Sleepdealr/RPAD/README.md

This work is licensed under a **Creative Commons Attribution-NonCommercial-ShareAlike 4.0 International License**.

# RPAD
A macropad designed using the RP2040

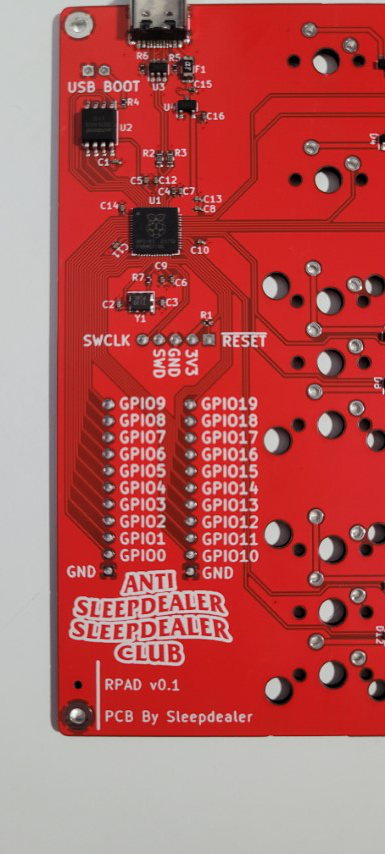
[picture p1: img/RPAD.jpg]
PDF of schematic
