Sleepdealr/RPAD/Firmware/rpad/readme.md

# RPAD

RPAD

*A short description of the keyboard/project*

* Keyboard Maintainer: [Sleepdealer](https://github.com/Sleepdealr)
* Hardware Supported: RPAD PCB
* Hardware Availability: *Links to where you can find this hardware*

Make example for this keyboard (after setting up your build environment):

    make sleepdealer/rpad:default

Flashing example for this keyboard by `picotool`:

    make sleepdealer/rpad:default:flash

Convert firmware into uf2 format:

    make sleepdealer/rpad:default:uf2

To replace Pro Micro to Pico Micro, use `CTPIM=yes` (`CONVERT_TO_PICO_MICRO=yes`):

    make <your_keyboard>:<your_keyamp>:<output option> CTPIM=yes

See the [build environment setup](https://docs.qmk.fm/#/getting_started_build_tools) and the [make instructions](https://docs.qmk.fm/#/getting_started_make_guide) for more information. Brand new to QMK? Start with our [Complete Newbs Guide](https://docs.qmk.fm/#/newbs).

## Bootloader

Enter the bootloader in 3 ways:

* **Bootmagic reset**: Hold down the key at (0,0) in the matrix (usually the top left key or Escape) and plug in the keyboard
* **Physical reset button**: Briefly press the button on the back of the PCB - some may have pads you must short instead
* **Keycode in layout**: Press the key mapped to `RESET` if it is available
