Sleepdealr/RPAD/PCB/RPAD.kicad_pcb

## KiCad design PCB/RPAD.kicad_pcb (2021-12-07)

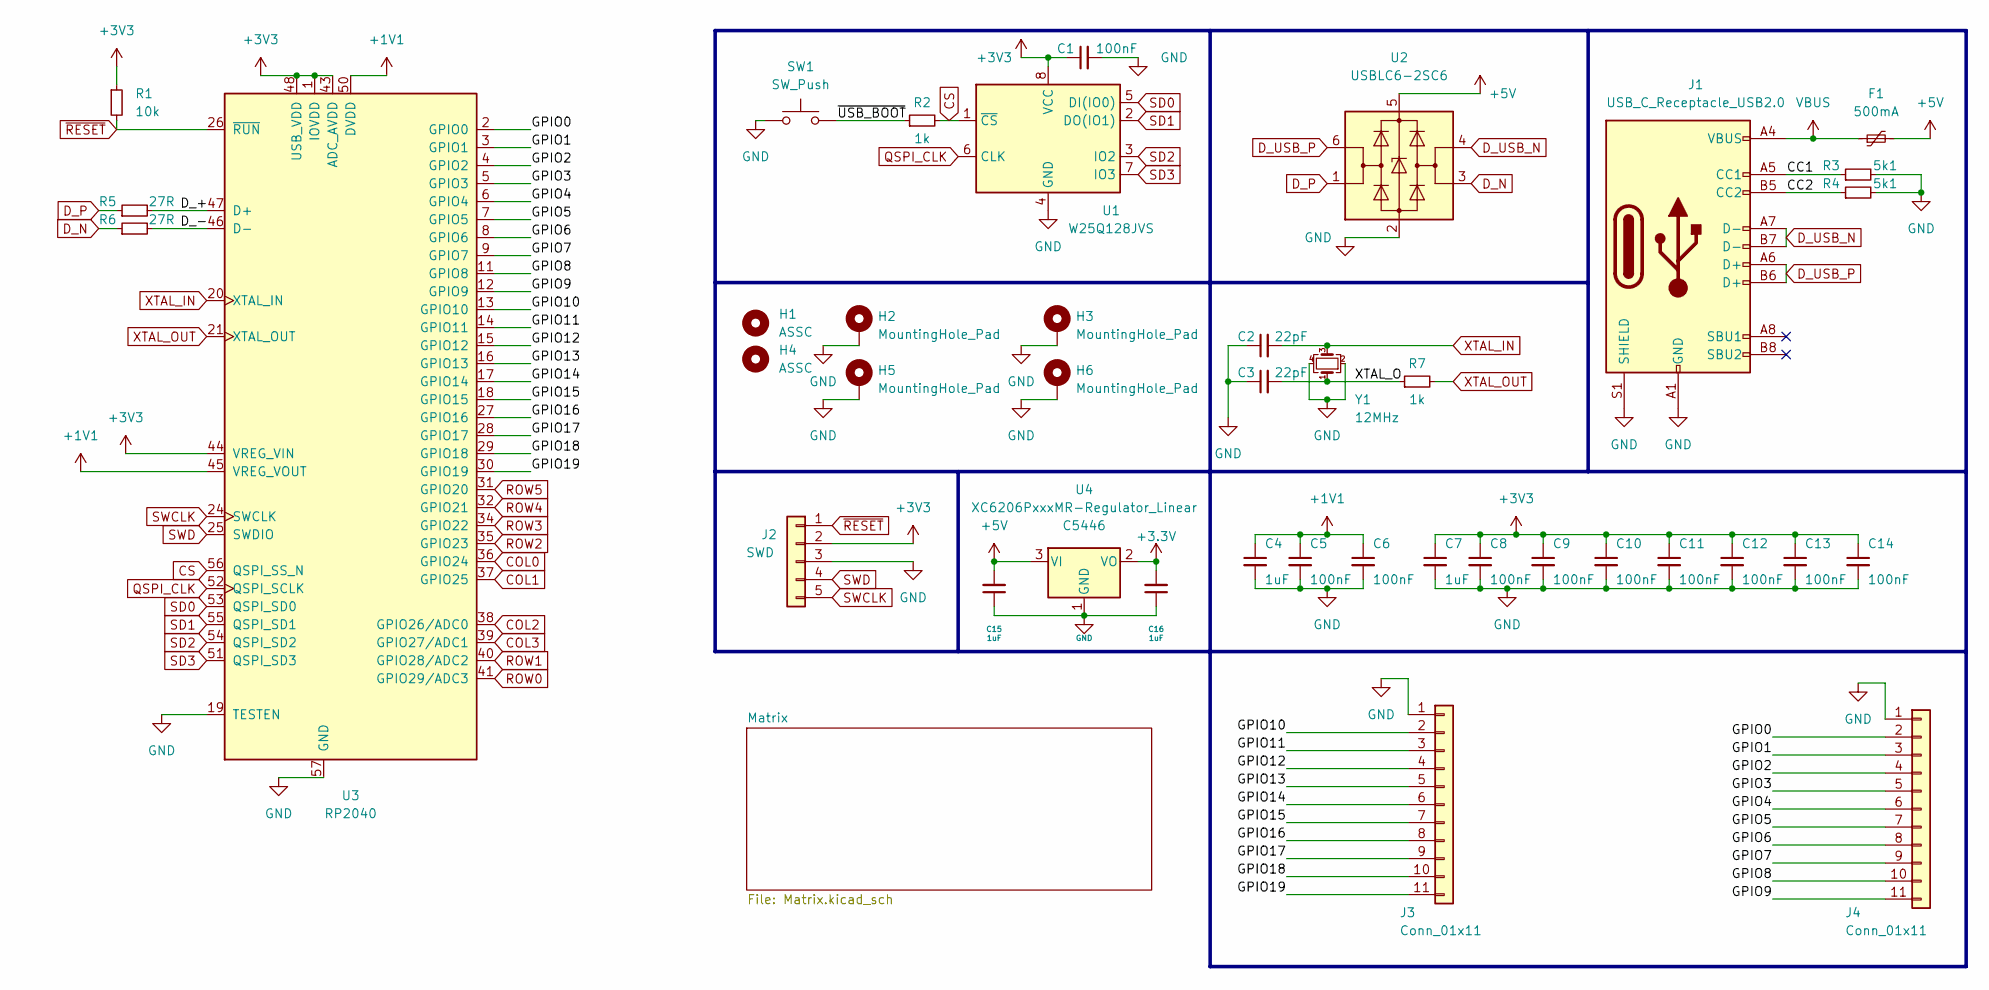
[picture p4: schematic RPAD.kicad_sch]

Parts:
C1, C5, C6, C8, C9, C10, C11, C12, C13, C14: 100nF; C_0402_1005Metric; LCSC C1525
C2, C3: 22pF; C_0402_1005Metric; LCSC C1555
C4, C7, C15, C16: 1uF; C_0402_1005Metric; LCSC C52923
F1: 500mA; Fuse_1206_3216Metric; LCSC C70076
H1, H4: ASSC; assc
H2, H3, H5, H6: MountingHole_Pad; MountingHole_2.2mm_M2_Pad
J1: USB_C_Receptacle_USB2.0; USB_C_Receptacle_HRO_TYPE-C-31-M-12; LCSC C165948
J2: SWD; PinSocket_1x05_P2.54mm_Vertical
J3, J4: Conn_01x11; PinSocket_1x11_P2.54mm_Vertical
R1: 10k; R_0402_1005Metric; LCSC C25744
R2, R7: 1k; R_0402_1005Metric; LCSC C11702
R3, R4: 5k1; R_0402_1005Metric; LCSC C25905
R5, R6: 27R; R_0603_1608Metric; LCSC C25190
SW1: SW_Push; PinSocket_1x02_P2.54mm_Vertical
U1: W25Q128JVS; SOIC-8_5.23x5.23mm_P1.27mm; LCSC C131025
U2: USBLC6-2SC6; SOT-23-6; LCSC C2827654
U3: RP2040; RP2040-QFN-56; LCSC C2040
U4: XC6206PxxxMR-Regulator_Linear; SOT-23; LCSC C5446
Y1: 12MHz; Crystal_SMD_3225-4Pin_3.2x2.5mm; LCSC C97242

Connections:
+1V1: C4.1, C5.1, C6.1, U3.23 (DVDD), U3.45 (VREG_VOUT), U3.50 (DVDD)
+5V: C15.2, F1.2, U2.5 (VBUS), U4.3 (VI)
/CC1: J1.A5 (CC1), R3.1
/CC2: J1.B5 (CC2), R4.1
/D_+: R5.2, U3.47 (D+)
/D_-: R6.2, U3.46 (D-)
/GPIO0: J4.2, U3.2 (GPIO0)
/GPIO1: J4.3, U3.3 (GPIO1)
/GPIO2: J4.4, U3.4 (GPIO2)
/GPIO3: J4.5, U3.5 (GPIO3)
/GPIO4: J4.6, U3.6 (GPIO4)
/GPIO5: J4.7, U3.7 (GPIO5)
/GPIO6: J4.8, U3.8 (GPIO6)
/GPIO7: J4.9, U3.9 (GPIO7)
/GPIO8: J4.10, U3.11 (GPIO8)
/GPIO9: J4.11, U3.12 (GPIO9)
/GPIO10: J3.2, U3.13 (GPIO10)
/GPIO11: J3.3, U3.14 (GPIO11)
/GPIO12: J3.4, U3.15 (GPIO12)
/GPIO13: J3.5, U3.16 (GPIO13)
/GPIO14: J3.6, U3.17 (GPIO14)
/GPIO15: J3.7, U3.18 (GPIO15)
/GPIO16: J3.8, U3.27 (GPIO16)
/GPIO17: J3.9, U3.28 (GPIO17)
/GPIO18: J3.10, U3.29 (GPIO18)
/GPIO19: J3.11, U3.30 (GPIO19)
/XTAL_O: C3.2, R7.1, Y1.1
/~USB_BOOT: R2.1, SW1.2
COL0: U3.36 (GPIO24); also elsewhere on the board
COL1: U3.37 (GPIO25); also elsewhere on the board
COL2: U3.38 (GPIO26/ADC0); also elsewhere on the board
COL3: U3.39 (GPIO27/ADC1); also elsewhere on the board
CS: R2.2, U1.1 (~CS), U3.56 (QSPI_SS_N)
D_N: R6.1, U2.3 (I/O2)
D_P: R5.1, U2.1 (I/O1)
D_USB_N: J1.A7 (D-), J1.B7 (D-), U2.4 (I/O2)
D_USB_P: J1.A6 (D+), J1.B6 (D+), U2.6 (I/O1)
GND: C1.2, C2.1, C3.1, C4.2, C5.2, C6.2, C7.2, C8.2, C9.2, C10.2, C11.2, C12.2, C13.2, C14.2, C15.1, C16.1, H2.1, H3.1, H5.1, H6.1, J1.A1 (GND), J1.A12 (GND), J1.B1 (GND), J1.B12 (GND), J1.S1 (SHIELD), J2.3, J3.1, J4.1, R3.2, R4.2, SW1.1, U1.4 (GND), U2.2 (GND), U3.19 (TESTEN), U3.57 (GND), U4.1 (GND), Y1.2, Y1.4
QSPI_CLK: U1.6 (CLK), U3.52 (QSPI_SCLK)
ROW0: U3.41 (GPIO29/ADC3); also elsewhere on the board
ROW1: U3.40 (GPIO28/ADC2); also elsewhere on the board
ROW2: U3.35 (GPIO23); also elsewhere on the board
ROW3: U3.34 (GPIO22); also elsewhere on the board
ROW4: U3.32 (GPIO21); also elsewhere on the board
ROW5: U3.31 (GPIO20); also elsewhere on the board
SD0: U1.5 (DI(IO0)), U3.53 (QSPI_SD0)
SD1: U1.2 (DO(IO1)), U3.55 (QSPI_SD1)
SD2: U1.3 (IO2), U3.54 (QSPI_SD2)
SD3: U1.7 (IO3), U3.51 (QSPI_SD3)
SWCLK: J2.5, U3.24 (SWCLK)
SWD: J2.4, U3.25 (SWDIO)
VBUS: F1.1, J1.A4 (VBUS), J1.A9 (VBUS), J1.B4 (VBUS), J1.B9 (VBUS)
XTAL_IN: C2.2, U3.20 (XTAL_IN), Y1.3
XTAL_OUT: R7.2, U3.21 (XTAL_OUT)
~RESET: J2.1, R1.2, U3.26 (~RUN)

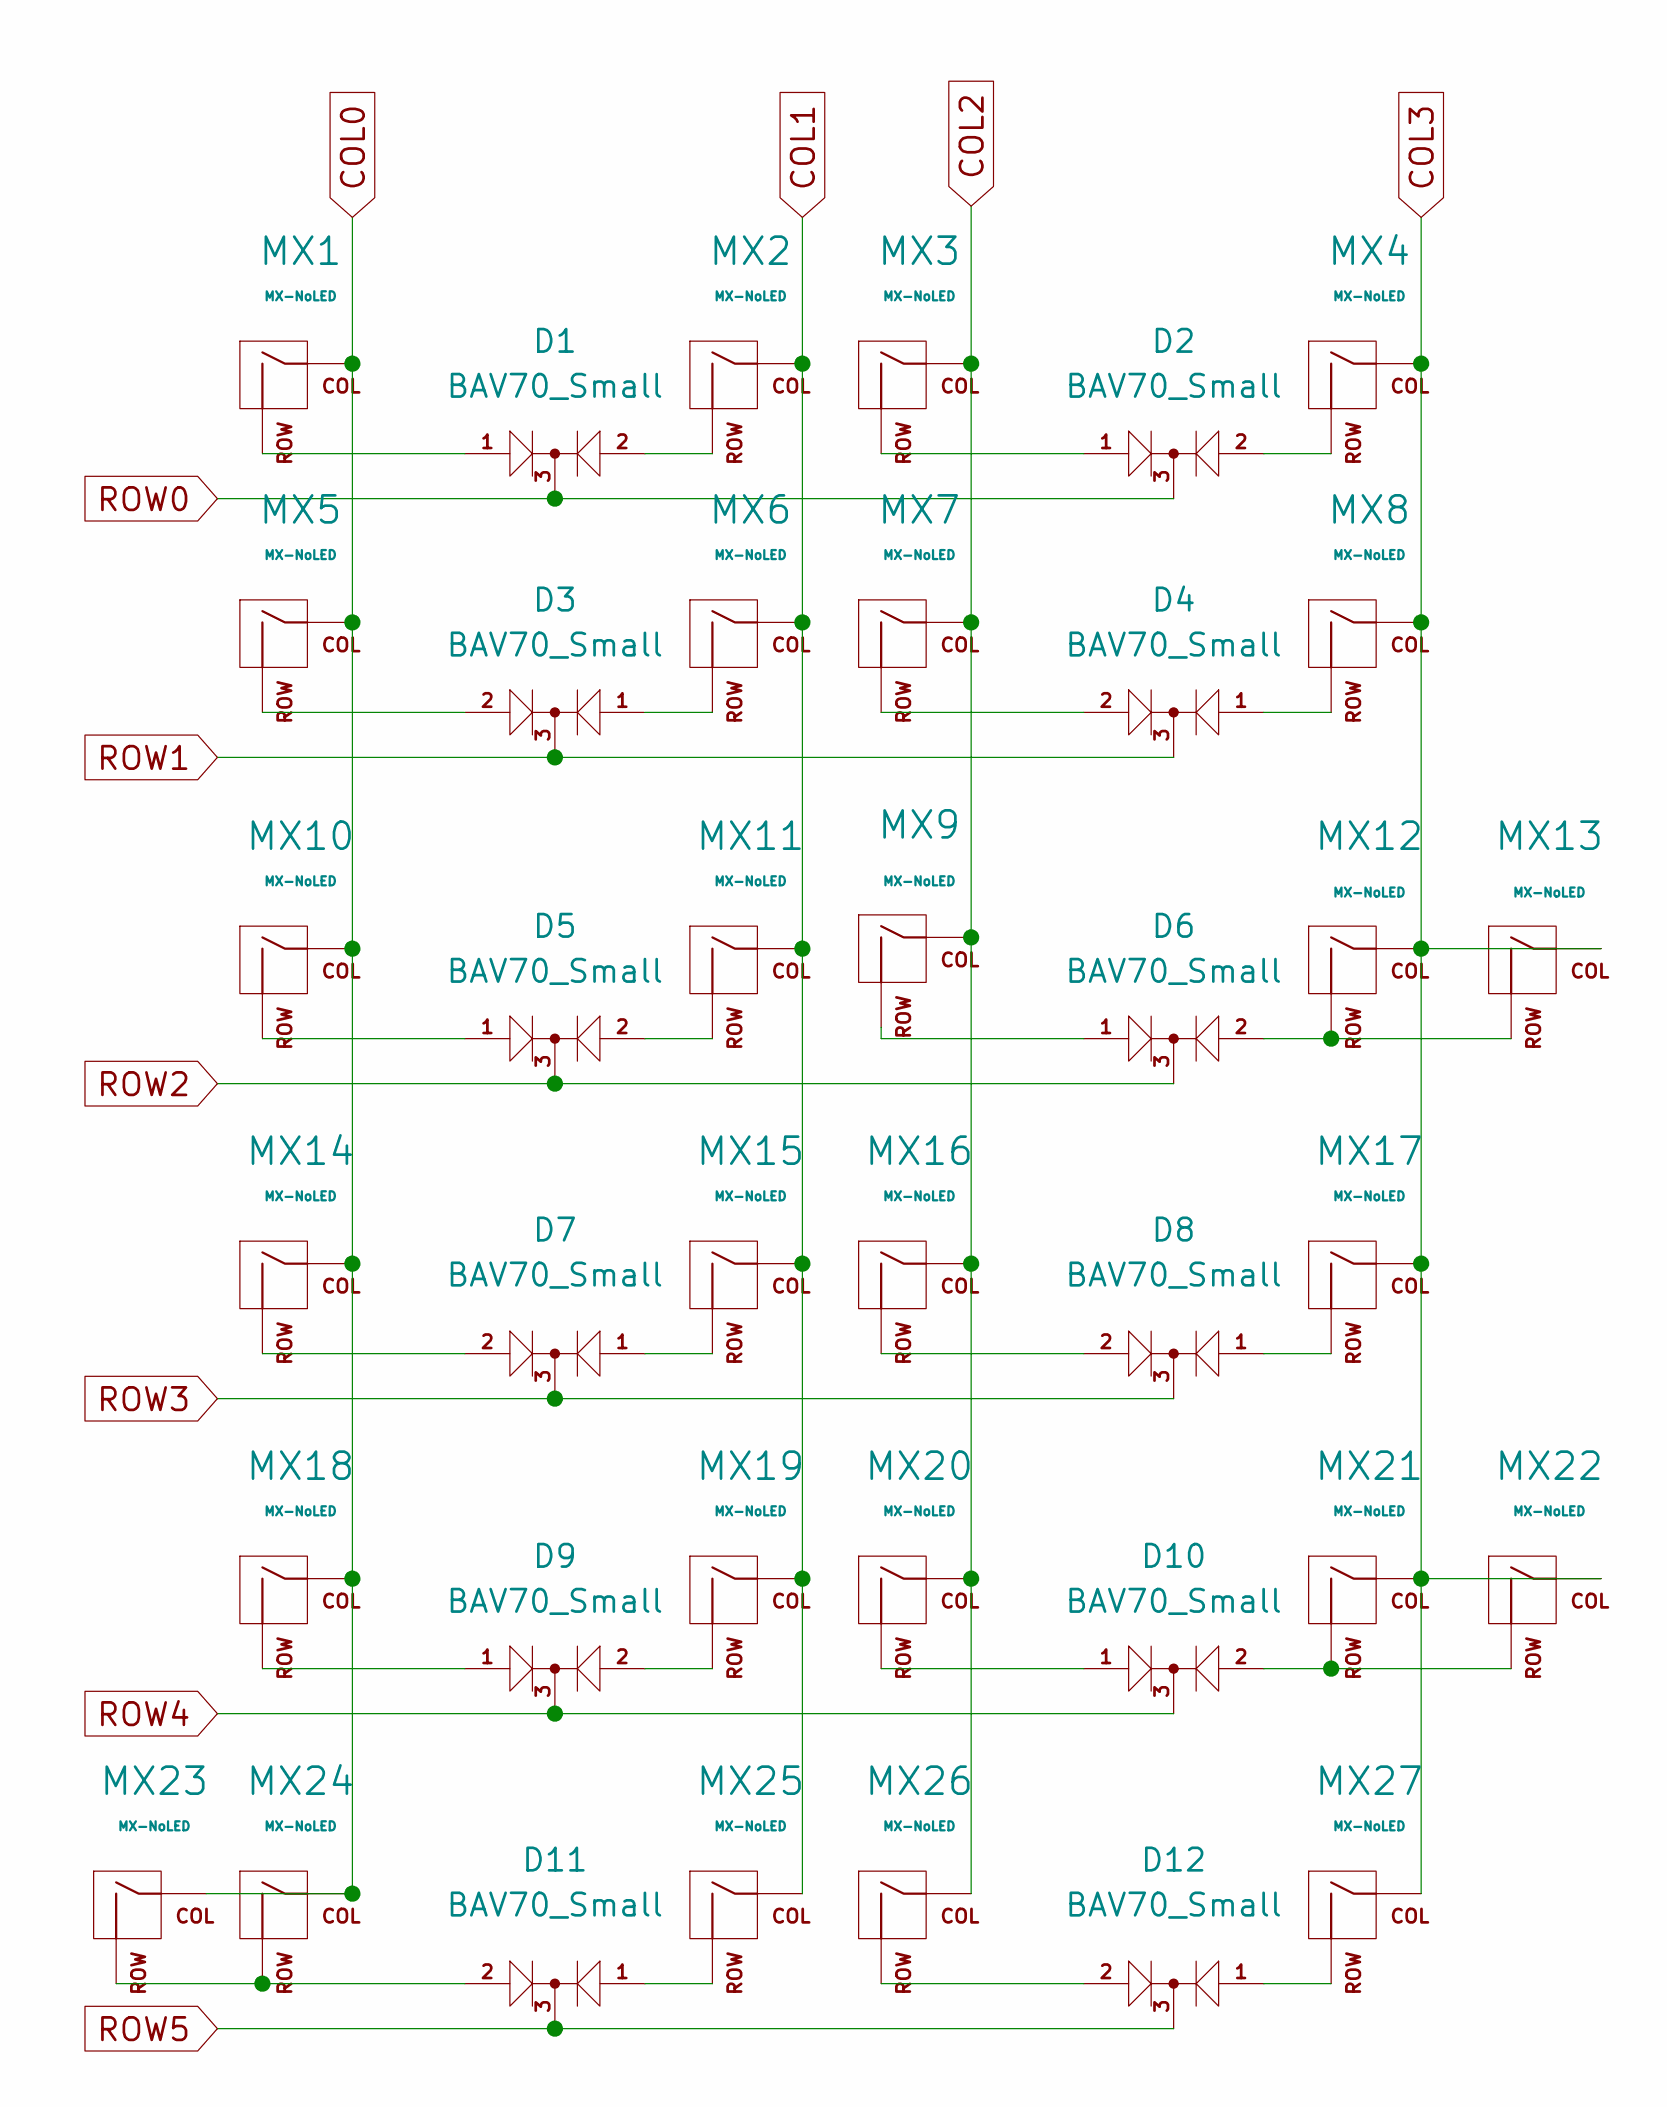
[picture p5: schematic Matrix.kicad_sch]

Parts:
D1, D2, D3, D4, D5, D6, D7, D8, D9, D10, D11, D12: BAV70_Small; SOT-23; LCSC C68978
MX1, MX2, MX3, MX4, MX5, MX6, MX7, MX8, MX9, MX10, MX11, MX12, MX14, MX15, MX16, MX17, MX18, MX19, MX20, MX21, MX24, MX25, MX26, MX27: MX-NoLED; MXOnly-1U-NoLED
MX13, MX22: MX-NoLED; MXOnly-2U-VerticalStabilizers-NoLED
MX23: MX-NoLED; MXOnly-2U-ReversedStabilizers-NoLED

Connections:
COL0: MX1.1 (COL), MX5.1 (COL), MX10.1 (COL), MX14.1 (COL), MX18.1 (COL), MX23.1 (COL), MX24.1 (COL); also elsewhere on the board
COL1: MX2.1 (COL), MX6.1 (COL), MX11.1 (COL), MX15.1 (COL), MX19.1 (COL), MX25.1 (COL); also elsewhere on the board
COL2: MX3.1 (COL), MX7.1 (COL), MX9.1 (COL), MX16.1 (COL), MX20.1 (COL), MX26.1 (COL); also elsewhere on the board
COL3: MX4.1 (COL), MX8.1 (COL), MX12.1 (COL), MX13.1 (COL), MX17.1 (COL), MX21.1 (COL), MX22.1 (COL), MX27.1 (COL); also elsewhere on the board
unnamed: D1.1 (A1), MX1.2 (ROW)
unnamed: D1.2 (A2), MX2.2 (ROW)
unnamed: D2.1 (A1), MX3.2 (ROW)
unnamed: D2.2 (A2), MX4.2 (ROW)
unnamed: D3.1 (A1), MX6.2 (ROW)
unnamed: D3.2 (A2), MX5.2 (ROW)
unnamed: D4.1 (A1), MX8.2 (ROW)
unnamed: D4.2 (A2), MX7.2 (ROW)
unnamed: D5.1 (A1), MX10.2 (ROW)
unnamed: D5.2 (A2), MX11.2 (ROW)
unnamed: D6.1 (A1), MX9.2 (ROW)
unnamed: D6.2 (A2), MX12.2 (ROW), MX13.2 (ROW)
unnamed: D7.1 (A1), MX15.2 (ROW)
unnamed: D7.2 (A2), MX14.2 (ROW)
unnamed: D8.1 (A1), MX17.2 (ROW)
unnamed: D8.2 (A2), MX16.2 (ROW)
unnamed: D9.1 (A1), MX18.2 (ROW)
unnamed: D9.2 (A2), MX19.2 (ROW)
unnamed: D10.1 (A1), MX20.2 (ROW)
unnamed: D10.2 (A2), MX21.2 (ROW), MX22.2 (ROW)
unnamed: D11.1 (A1), MX25.2 (ROW)
unnamed: D11.2 (A2), MX23.2 (ROW), MX24.2 (ROW)
unnamed: D12.1 (A1), MX27.2 (ROW)
unnamed: D12.2 (A2), MX26.2 (ROW)
ROW0: D1.3 (K), D2.3 (K); also elsewhere on the board
ROW1: D3.3 (K), D4.3 (K); also elsewhere on the board
ROW2: D5.3 (K), D6.3 (K); also elsewhere on the board
ROW3: D7.3 (K), D8.3 (K); also elsewhere on the board
ROW4: D9.3 (K), D10.3 (K); also elsewhere on the board
ROW5: D11.3 (K), D12.3 (K); also elsewhere on the board

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
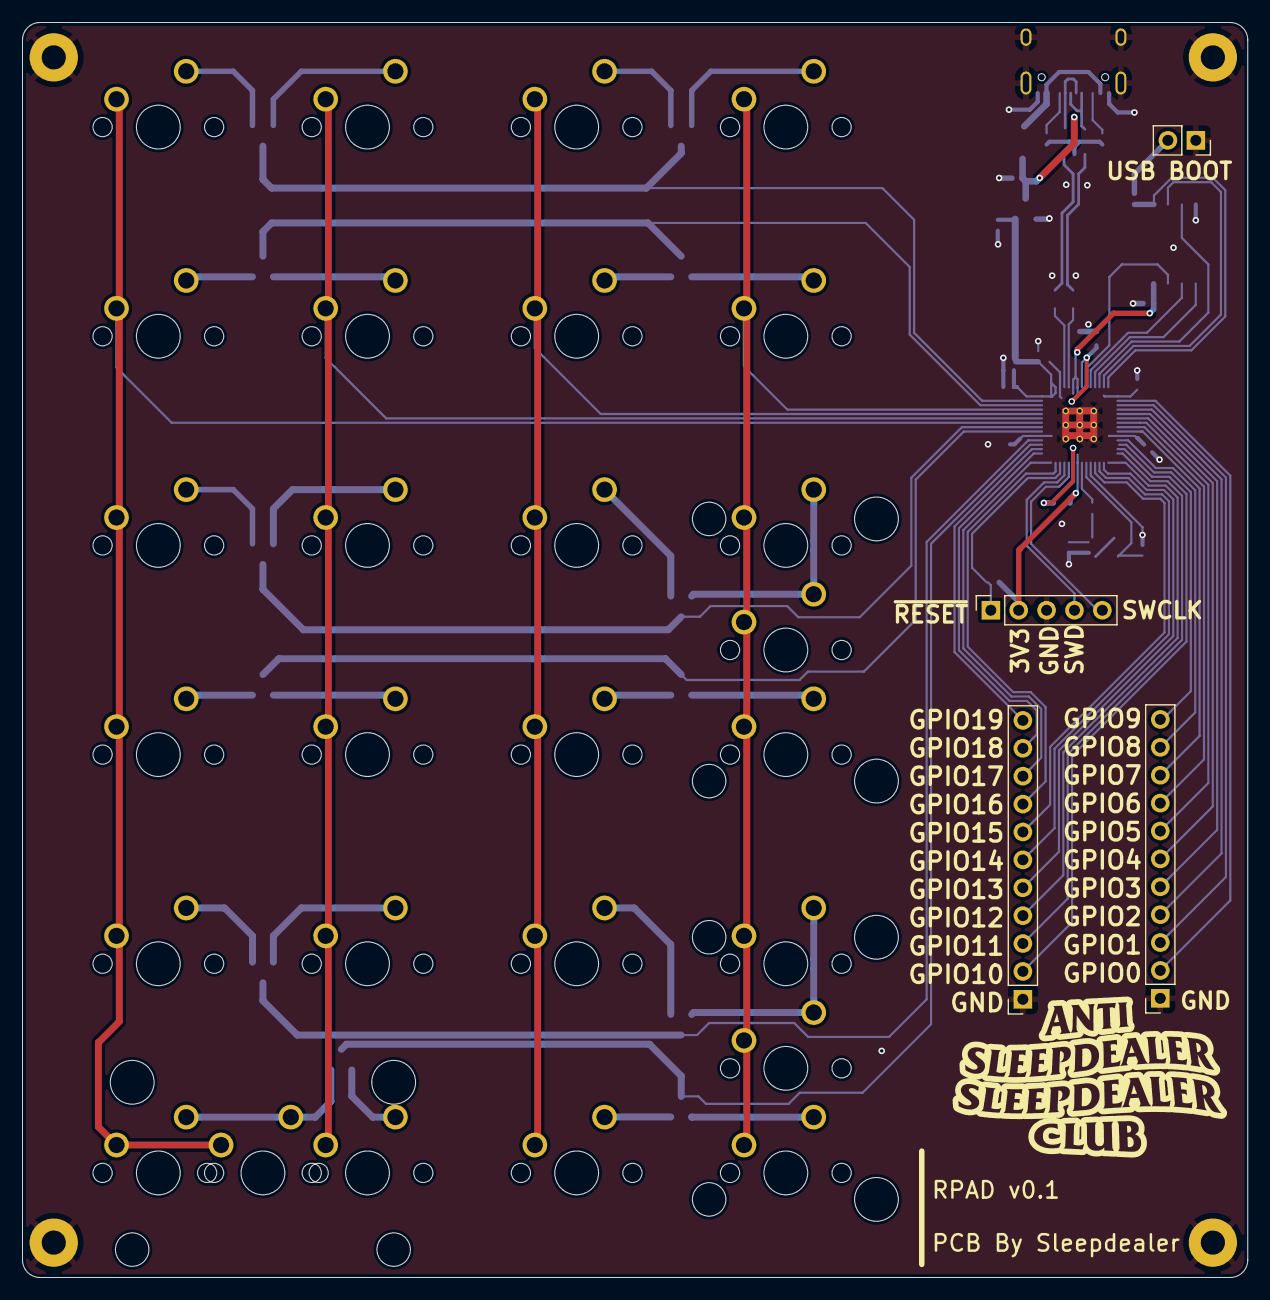
[picture p6: board RPAD.kicad_pcb from above]

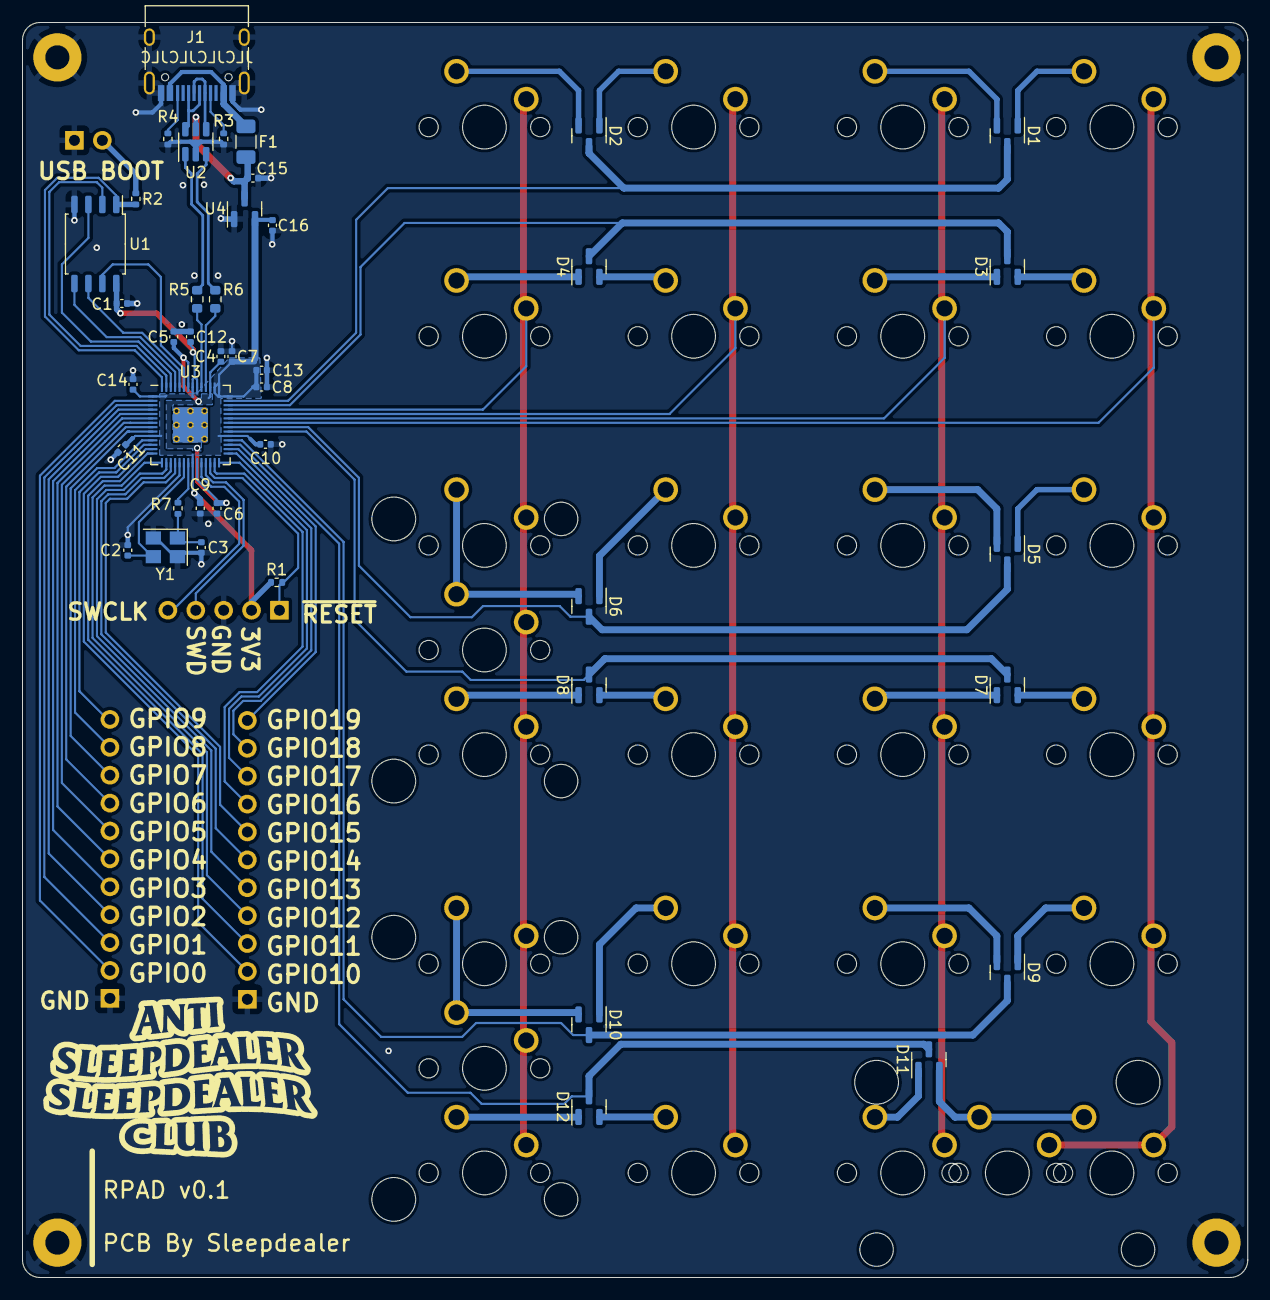
[picture p7: board RPAD.kicad_pcb from below]

Board: 2 copper layers, 111.6 x 114.3 mm, 79 parts (43 on the bottom side), 80 nets.
